TruthPointer/TFReadOnlyModeSwitcher/附件/2. Fritzing項目/成品製作文件/1. 萬能板背面跳綫焊接佈局直觀對照圖.jpg

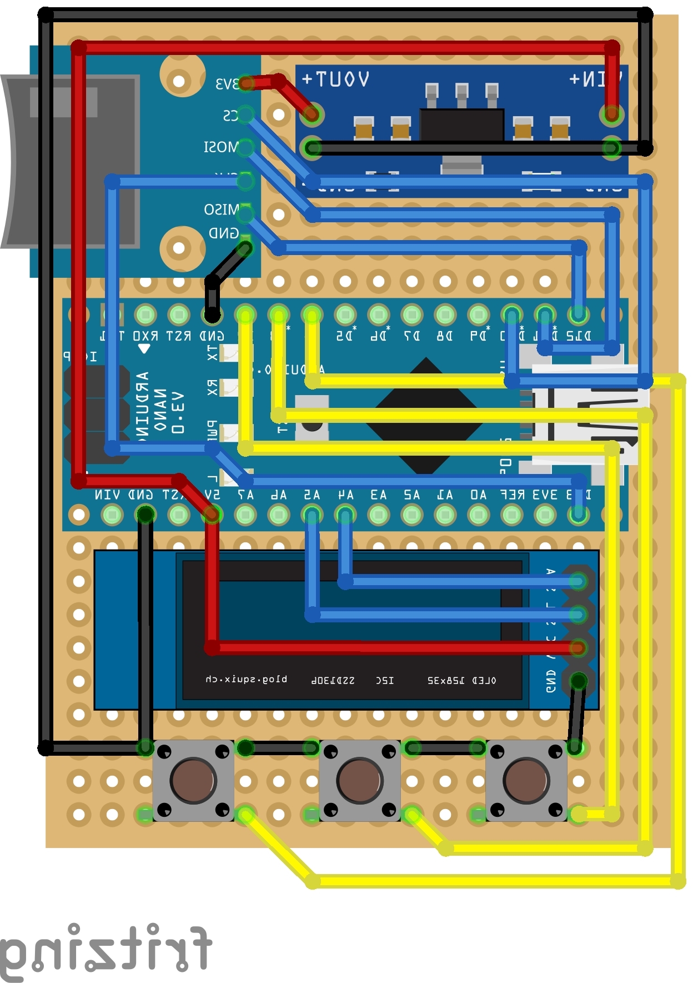
附件/2. Fritzing項目/成品製作文件/1. 萬能板背面跳綫焊接佈局直觀對照圖.jpg
