TruthPointer/TFReadOnlyModeSwitcher/README.md

# TFReadOnlyModeSwitcher
A hardwark making for TF card readonly mode.
