TruthPointer/TFReadOnlyModeSwitcher/附件/2. Fritzing項目/成品製作文件/2. PCB-1个.pdf

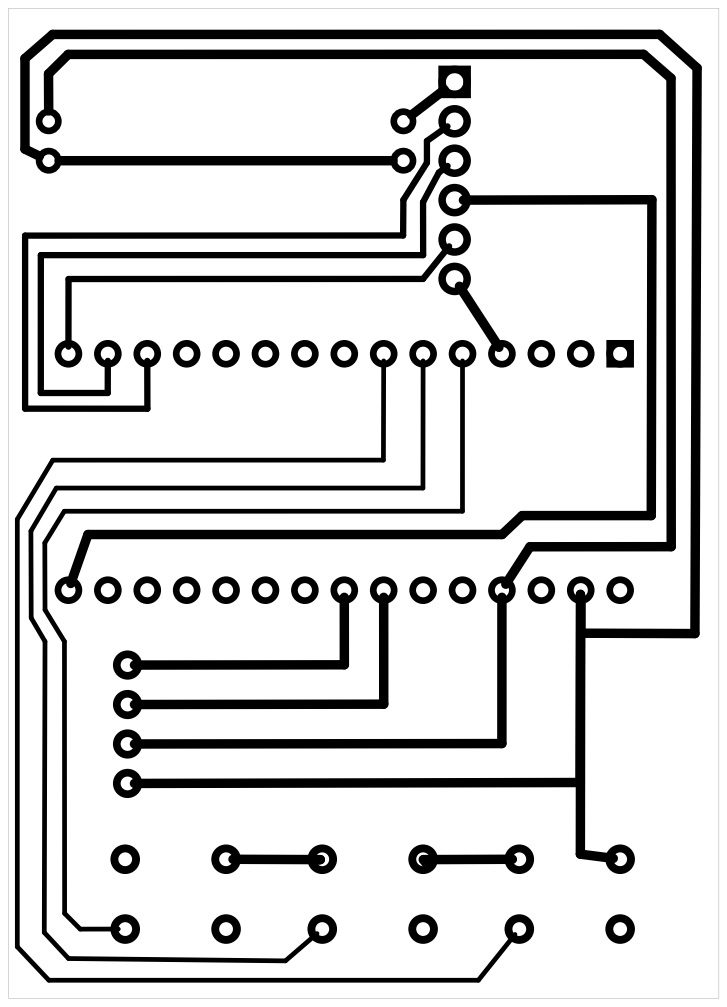
[picture p34: page 1]
