TruthPointer/TFReadOnlyModeSwitcher/(list of files, drawings)

Other design files:
附件/2. Fritzing項目/Set_TWP_By_Nano_M3_CB(18x24)-PCB(46x64).fzz
