TruthPointer/TFReadOnlyModeSwitcher/(notices)

Notices in the files:
附件/1. Arduino項目/set_twp_for_tf_card/SdInfoV2.h:
This Library is free software: you can redistribute it and/or modify
it under the terms of the GNU General Public License as published by
the Free Software Foundation, either version 3 of the License, or
(at your option) any later version.
